dnnspaul/paulander/sketch/sketch.ino

#include <Wire.h>
#include <GxEPD2_BW.h>
#include <GxEPD2_3C.h>
#include <Fonts/FreeMonoBold9pt7b.h>
#include <Fonts/FreeMonoBold12pt7b.h>
#include <Fonts/FreeMono9pt7b.h>
#include <ArduinoJson.h>
#include <time.h>

// Pin definitions for 7.5" B&W e-paper display
#define EPD_CS 5
#define EPD_DC 2
#define EPD_RST 4
#define EPD_BUSY 15
#define EPD_PWR 0

// I2C configuration - using working parameters from your test
#define I2C_SDA 21
#define I2C_SCL 22
#define I2C_ADDRESS 0x42  // Changed to match Python code expectations

// Display object for Waveshare 7.5" V2 B&W display (800x480)
GxEPD2_BW<GxEPD2_750_T7, GxEPD2_750_T7::HEIGHT> display(GxEPD2_750_T7(EPD_CS, EPD_DC, EPD_RST, EPD_BUSY));

// Enhanced data structure for weather and calendar info
struct WeatherData {
  float current_temperature;
  char current_description[64];
  float today_min;
  float today_max;
  char today_description[64];
  float tomorrow_min;
  float tomorrow_max;
  char tomorrow_description[64];
  bool has_tomorrow_data;
  char location[32];
  int humidity;          // Humidity percentage
  float wind_speed;      // Wind speed
  uint32_t timestamp;
};

struct CalendarEvent {
  char title[64];
  char location[32];
  uint32_t start_time;
  bool valid;
  bool all_day;
};

struct DisplayData {
  WeatherData weather;
  CalendarEvent events[6];  // Max 6 events
  uint8_t event_count;
  uint32_t data_hash;  // Local hash to detect changes
  char received_hash[16];  // Hash received from Python backend
  uint32_t timestamp;
};

// Global variables
DisplayData currentData;
DisplayData previousData;
bool dataReceived = false;
bool displayNeedsUpdate = false;
bool displayInitialized = false;
unsigned long lastDisplayUpdate = 0;
const unsigned long DISPLAY_UPDATE_INTERVAL = 1800000;  // 30 minutes in ms
uint32_t skippedUpdates = 0;  // Counter for skipped updates due to hash matching

// I2C receive buffer - 2KB to handle complete data structure with headroom
uint8_t i2cBuffer[2048];  // 2KB buffer for reliable data reception
volatile bool i2cDataReady = false;
volatile int i2cDataLength = 0;
volatile int totalDataReceived = 0;
volatile bool receivingMultipart = false;
volatile unsigned long lastReceiveTime = 0;  // Global variable for timeout tracking

void setup() {
  Serial.begin(115200);
  Serial.println("\n=== Paulander ESP32 B&W Display Controller ===");

  // Configure timezone for Europe/Berlin (no WiFi needed, just local timezone setting)
  setenv("TZ", "CET-1CEST,M3.5.0,M10.5.0/3", 1);
  tzset();
  Serial.println("Timezone set to Europe/Berlin (CET/CEST)");

  // Debug: Print structure sizes
  Serial.printf("WeatherData size: %d bytes\n", sizeof(WeatherData));
  Serial.printf("CalendarEvent size: %d bytes\n", sizeof(CalendarEvent));
  Serial.printf("DisplayData size: %d bytes\n", sizeof(DisplayData));
  Serial.printf("Expected data from Pi: 719 bytes\n");

  // Initialize I2C first with explicit parameters (like your working test)
  Serial.println("Initializing I2C slave communication...");
  Wire.begin(I2C_ADDRESS, I2C_SDA, I2C_SCL, 100000);  // Address, SDA, SCL, Frequency
  Wire.onReceive(onI2CReceive);
  Wire.onRequest(onI2CRequest);

  Serial.printf("I2C initialized as slave at address 0x%02X\n", I2C_ADDRESS);
  Serial.printf("SDA: GPIO%d, SCL: GPIO%d\n", I2C_SDA, I2C_SCL);

  // Initialize display (but make it more robust)
  initializeDisplay();

  // Initialize data structures
  memset(&currentData, 0, sizeof(DisplayData));
  memset(&previousData, 0, sizeof(DisplayData));
  
  // Initialize hash fields
  strcpy(currentData.received_hash, "initial");
  strcpy(previousData.received_hash, "none");

  // Initialize I2C timing
  lastReceiveTime = millis();

  Serial.println("ESP32 ready for I2C communication");
  Serial.println("Waiting for data from Raspberry Pi...");

  // Show startup message only if display initialized
  if (displayInitialized) {
    showStartupMessage();
  }
}

void loop() {
  // Check for I2C data
  if (i2cDataReady) {
    processI2CData();
    i2cDataReady = false;
  }

  // Check for I2C receive timeout
  if (receivingMultipart && (millis() - lastReceiveTime > 15000)) {  // Increased to 15 seconds
    Serial.printf("I2C receive timeout - received %d bytes (expected JSON data)\n", totalDataReceived);

    // Check if we have complete JSON even though we timed out
    if (isJsonComplete()) {
      Serial.println("Data size close to expected - processing anyway");
      i2cDataLength = totalDataReceived;
      i2cDataReady = true;
    } else {
      Serial.println("Insufficient data - resetting buffer");
      // Clear the buffer completely to avoid contamination
      memset(i2cBuffer, 0, sizeof(i2cBuffer));
    }

    totalDataReceived = 0;
    receivingMultipart = false;
    lastReceiveTime = millis();
  }

  // Check if display needs update
  bool timeBasedUpdate = (millis() - lastDisplayUpdate > DISPLAY_UPDATE_INTERVAL);
  
  if (displayNeedsUpdate || timeBasedUpdate) {
    if (dataReceived && displayInitialized) {
      if (displayNeedsUpdate) {
        Serial.println("Display update triggered by data change");
      } else if (timeBasedUpdate) {
        Serial.println("Display update triggered by time interval (30 min)");
      }
      
      updateDisplay();
      displayNeedsUpdate = false;
      lastDisplayUpdate = millis();
    }
  }

  // Keep alive message every 10 seconds
  static unsigned long lastKeepAlive = 0;
  if (millis() - lastKeepAlive > 10000) {
    if (receivingMultipart) {
      Serial.printf("ESP32 running... (receiving multipart: %d bytes received)\n", totalDataReceived);
    } else {
      Serial.printf("ESP32 running... (data received: %s, skipped updates: %u)\n", dataReceived ? "yes" : "no", skippedUpdates);
    }
    lastKeepAlive = millis();
  }

  delay(100);  // Small delay to prevent busy waiting
}

void initializeDisplay() {
  Serial.println("Initializing 7.5\" B&W e-paper display...");

  try {
    delay(1000);  // Initialization pause

    // Power pin
    if (EPD_PWR >= 0) {
      pinMode(EPD_PWR, OUTPUT);
      digitalWrite(EPD_PWR, HIGH);
      delay(500);
      Serial.println("Power pin activated");
    }

    // Set pin modes explicitly
    pinMode(EPD_CS, OUTPUT);
    pinMode(EPD_DC, OUTPUT);
    pinMode(EPD_RST, OUTPUT);
    pinMode(EPD_BUSY, INPUT);

    digitalWrite(EPD_CS, HIGH);
    digitalWrite(EPD_DC, LOW);
    digitalWrite(EPD_RST, HIGH);

    display.init(115200, true, 2, false);

    // Set rotation for portrait mode (90 degrees clockwise)
    display.setRotation(3);

    Serial.println("✓ Display initialized successfully!");
    Serial.printf("Display size: %dx%d (after rotation)\n", display.width(), display.height());

    // Wait until display is ready
    Serial.println("Waiting for display readiness...");
    int timeout = 0;
    while (digitalRead(EPD_BUSY) == LOW && timeout < 50) {
      delay(100);
      timeout++;
      Serial.print(".");
    }
    Serial.println("\nDisplay is ready!");

    displayInitialized = true;

  } catch (...) {
    Serial.println("✗ Display initialization failed!");
    Serial.println("Continuing without display (I2C will still work)");
    displayInitialized = false;
  }
}

void onI2CReceive(int length) {
  if (length > 0) {
    // If this is the first chunk of a new transmission, clear buffer
    if (totalDataReceived == 0) {
      memset(i2cBuffer, 0, sizeof(i2cBuffer));
      Serial.println("Starting new I2C transmission - buffer cleared");
    }

    // Read all available bytes
    int bytesRead = 0;
    while (Wire.available() && (totalDataReceived + bytesRead) < sizeof(i2cBuffer)) {
      i2cBuffer[totalDataReceived + bytesRead] = Wire.read();
      bytesRead++;
    }

    totalDataReceived += bytesRead;
    Serial.printf("I2C chunk received: %d bytes (total: %d)\n", bytesRead, totalDataReceived);

    // Debug: Show first few bytes of this chunk if it's the first one
    if (totalDataReceived <= 32) {
      Serial.printf("First chunk bytes: ");
      for (int i = 0; i < min(8, bytesRead); i++) {
        uint8_t byte = i2cBuffer[totalDataReceived - bytesRead + i];
        if (byte >= 32 && byte <= 126) {
          Serial.printf("'%c' ", byte);  // Show printable characters
        } else {
          Serial.printf("0x%02X ", byte);  // Show non-printable as hex
        }
      }
      Serial.println();
    }

    // Check if we have received complete JSON data
    if (isJsonComplete()) {
      Serial.printf("Complete data received: %d bytes (expected: %d)\n", totalDataReceived, sizeof(DisplayData));
      i2cDataLength = totalDataReceived;
      i2cDataReady = true;
      totalDataReceived = 0;  // Reset for next message
      receivingMultipart = false;
    } else {
      // We're in the middle of receiving a multi-part message
      receivingMultipart = true;

      // Update global timeout timer
      lastReceiveTime = millis();

      // Check for timeout in main loop
    }
  }
}

bool isJsonComplete() {
  // Check if we have received complete JSON data
  if (totalDataReceived < 20) return false;  // Minimum for basic JSON structure

  bool foundStart = false;
  int braceCount = 0;

  for (int i = 0; i < totalDataReceived; i++) {
    if (i2cBuffer[i] == 0x00) continue;  // Skip register bytes

    if (i2cBuffer[i] == '{') {
      if (!foundStart) foundStart = true;
      braceCount++;
    } else if (i2cBuffer[i] == '}' && foundStart) {
      braceCount--;
      if (braceCount == 0) {
        Serial.printf("JSON completion detected at position %d (braces balanced)\n", i);
        return true;
      }
    }
  }

  return false;
}

void onI2CRequest() {
  // Send status back to Raspberry Pi
  uint8_t status = dataReceived ? 1 : 0;
  Wire.write(status);
  Serial.printf("I2C status request - sent: %d\n", status);
}

void processI2CData() {
  Serial.printf("Processing I2C data: %d bytes\n", i2cDataLength);

  if (i2cDataLength >= 50) {  // JSON should be at least 50 bytes
    // Reconstruct JSON by removing register bytes (0x00) from chunks
    // Each 16-byte chunk starts with 0x00, so we need to clean this up
    uint8_t cleanBuffer[2048];
    int cleanLength = 0;

    Serial.println("Reconstructing JSON from I2C chunks...");
    for (int i = 0; i < i2cDataLength;) {
      if (i2cBuffer[i] == 0x00) {
        // Skip register byte
        i++;
        Serial.printf("Skipped register byte at position %d\n", i - 1);
      } else {
        // Copy data byte
        cleanBuffer[cleanLength++] = i2cBuffer[i];
        i++;
      }
    }

    // Null-terminate the JSON string
    cleanBuffer[cleanLength] = '\0';

    Serial.printf("Reconstructed JSON: %d bytes (from %d raw bytes)\n", cleanLength, i2cDataLength);

    Serial.println("=== JSON Data Debug ===");
    Serial.printf("Clean JSON length: %d bytes\n", cleanLength);
    Serial.printf("Clean JSON data: %s\n", (char*)cleanBuffer);

    // Parse JSON from clean buffer
    DynamicJsonDocument doc(2048);  // 2KB for JSON parsing
    DeserializationError error = deserializeJson(doc, (char*)cleanBuffer);

    if (error) {
      Serial.printf("✗ JSON parsing failed: %s\n", error.c_str());
      return;
    }

    Serial.println("✓ JSON parsed successfully");

    // Extract enhanced weather data
    currentData.weather.current_temperature = doc["weather"]["current_temperature"];
    strncpy(currentData.weather.current_description, doc["weather"]["current_description"] | "", sizeof(currentData.weather.current_description) - 1);
    currentData.weather.today_min = doc["weather"]["today_min"];
    currentData.weather.today_max = doc["weather"]["today_max"];
    strncpy(currentData.weather.today_description, doc["weather"]["today_description"] | "", sizeof(currentData.weather.today_description) - 1);
    
    // Check if tomorrow data is available
    if (doc["weather"]["tomorrow_min"].isNull() || doc["weather"]["tomorrow_max"].isNull()) {
      currentData.weather.has_tomorrow_data = false;
      currentData.weather.tomorrow_min = 0;
      currentData.weather.tomorrow_max = 0;
      strncpy(currentData.weather.tomorrow_description, "No forecast", sizeof(currentData.weather.tomorrow_description) - 1);
    } else {
      currentData.weather.has_tomorrow_data = true;
      currentData.weather.tomorrow_min = doc["weather"]["tomorrow_min"];
      currentData.weather.tomorrow_max = doc["weather"]["tomorrow_max"];
      strncpy(currentData.weather.tomorrow_description, doc["weather"]["tomorrow_description"] | "No forecast", sizeof(currentData.weather.tomorrow_description) - 1);
    }
    
    strncpy(currentData.weather.location, doc["weather"]["location"] | "", sizeof(currentData.weather.location) - 1);
    
    // Extract new modern display fields (no icons)
    currentData.weather.humidity = doc["weather"]["humidity"] | 0;
    currentData.weather.wind_speed = doc["weather"]["wind_speed"] | 0.0;
    
    currentData.weather.timestamp = doc["weather"]["timestamp"];

    // Extract events data
    currentData.event_count = doc["event_count"];
    if (currentData.event_count > 6) currentData.event_count = 6;  // Safety check

    JsonArray events = doc["events"];
    for (int i = 0; i < currentData.event_count && i < 6; i++) {
      strncpy(currentData.events[i].title, events[i]["title"] | "", sizeof(currentData.events[i].title) - 1);
      strncpy(currentData.events[i].location, events[i]["location"] | "", sizeof(currentData.events[i].location) - 1);
      currentData.events[i].start_time = events[i]["start_time"];
      currentData.events[i].valid = events[i]["valid"];
      currentData.events[i].all_day = events[i]["all_day"] | false;
    }

    currentData.timestamp = doc["timestamp"];
    
    // Extract received hash from Python backend
    strncpy(currentData.received_hash, doc["data_hash"] | "", sizeof(currentData.received_hash) - 1);
    currentData.received_hash[sizeof(currentData.received_hash) - 1] = '\0';  // Ensure null termination

    // Calculate hash of current data for change detection
    uint32_t newHash = calculateDataHash(&currentData);

    Serial.println("=== JSON Data Processed Successfully ===");
    Serial.printf("Current Temperature: %.1f°C\n", currentData.weather.current_temperature);
    Serial.printf("Current Weather: %s\n", currentData.weather.current_description);
    Serial.printf("Humidity: %d%%, Wind: %.1fm/s\n", currentData.weather.humidity, currentData.weather.wind_speed);
    Serial.printf("Today: %.1f-%.1f°C, %s\n", currentData.weather.today_min, currentData.weather.today_max, currentData.weather.today_description);
    if (currentData.weather.has_tomorrow_data) {
      Serial.printf("Tomorrow: %.1f-%.1f°C, %s\n", currentData.weather.tomorrow_min, currentData.weather.tomorrow_max, currentData.weather.tomorrow_description);
    } else {
      Serial.println("Tomorrow: No forecast available");
    }
    Serial.printf("Location: %s\n", currentData.weather.location);
    Serial.printf("Events: %d\n", currentData.event_count);

    // Debug calendar events
    Serial.println("=== Calendar Events ===");
    for (int i = 0; i < currentData.event_count && i < 6; i++) {
      CalendarEvent& event = currentData.events[i];
      Serial.printf("Event %d: '%s'\n", i + 1, event.title);
      Serial.printf("  Location: '%s'\n", event.location);
      Serial.printf("  Start time: %u\n", event.start_time);
      Serial.printf("  Valid: %s\n", event.valid ? "yes" : "no");

      // Convert timestamp to readable format
      if (event.start_time > 0) {
        time_t eventTime = event.start_time;
        struct tm* timeInfo = localtime(&eventTime);
        Serial.printf("  Readable time: %02d/%02d %02d:%02d\n",
                      timeInfo->tm_mon + 1, timeInfo->tm_mday,
                      timeInfo->tm_hour, timeInfo->tm_min);
      }
    }

    Serial.printf("Local data hash: 0x%08X\n", newHash);
    Serial.printf("Received hash: %s\n", currentData.received_hash);

    // Enhanced change detection using both local hash and received hash
    bool localHashChanged = (newHash != previousData.data_hash);
    bool receivedHashChanged = (strcmp(currentData.received_hash, previousData.received_hash) != 0);
    
    if (localHashChanged || receivedHashChanged) {
      if (localHashChanged && receivedHashChanged) {
        Serial.println("✓ Data changed (both local and received hash) - display update needed");
      } else if (localHashChanged) {
        Serial.println("✓ Data changed (local hash) - display update needed");
      } else {
        Serial.println("✓ Data changed (received hash) - display update needed");
      }
      
      displayNeedsUpdate = true;
      previousData = currentData;
      previousData.data_hash = newHash;
      strncpy(previousData.received_hash, currentData.received_hash, sizeof(previousData.received_hash));
    } else {
      skippedUpdates++;
      Serial.printf("✓ Data unchanged (both hashes match) - no display update needed (skipped: %u)\n", skippedUpdates);
    }

    currentData.data_hash = newHash;
    dataReceived = true;
  } else {
    Serial.printf("✗ Insufficient I2C data: %d bytes (expected: 50+ bytes for JSON)\n", i2cDataLength);
  }
}

uint32_t calculateDataHash(DisplayData* data) {
  // Simple hash calculation for change detection
  uint32_t hash = 0;
  uint8_t* ptr = (uint8_t*)data;
  for (int i = 0; i < sizeof(DisplayData) - sizeof(uint32_t); i++) {
    hash = hash * 31 + ptr[i];
  }
  return hash;
}

void showStartupMessage() {
  if (!displayInitialized) return;

  display.fillScreen(GxEPD_WHITE);
  display.setTextColor(GxEPD_BLACK);
  display.setFont(&FreeMonoBold12pt7b);

  display.setCursor(50, 80);
  display.print("Paulander Display Controller");

  display.setFont(&FreeMono9pt7b);
  display.setCursor(50, 120);
  display.print("ESP32 Controller ready");

  display.setCursor(50, 150);
  display.print("I2C Address: 0x42 (0x2A)");

  display.setCursor(50, 180);
  display.print("Waiting for data from Raspberry Pi...");

  display.setCursor(50, 240);
  display.print("This shouldn't take longer");

  display.setCursor(50, 270);
  display.print("than 30 minutes!");

  // Draw border
  display.drawRect(20, 20, display.width() - 40, display.height() - 40, GxEPD_BLACK);

  Serial.println("Displaying startup message...");
  display.display();
  Serial.println("✓ Startup message displayed");
}

void updateDisplay() {
  if (!dataReceived || !displayInitialized) return;

  // Additional safety check - only update if we truly have new data
  if (!displayNeedsUpdate) {
    Serial.println("=== Display update skipped - no changes detected ===");
    return;
  }

  Serial.println("=== Updating Modern B&W Display ===");
  Serial.printf("Updating display due to data changes (hash: %s)\n", currentData.received_hash);

  display.fillScreen(GxEPD_WHITE);
  display.setTextColor(GxEPD_BLACK);

  // Modern card-based layout
  drawModernHeader();
  drawModernWeatherCards();
  drawModernEventsTimeline();
  drawModernFooter();

  Serial.println("Refreshing modern display (this may take 10-30 seconds)...");
  unsigned long startTime = millis();
  display.display();
  unsigned long endTime = millis();

  Serial.printf("✓ Modern display updated successfully in %lu ms\n", endTime - startTime);
}

void drawModernHeader() {
  // Two-line header: bold weekday on top, date (and optionally location) below.
  static const char* weekdays[] = {"Sonntag", "Montag", "Dienstag", "Mittwoch",
                                   "Donnerstag", "Freitag", "Samstag"};
  static const char* months[] = {"Januar", "Februar", "Maerz", "April", "Mai", "Juni",
                                 "Juli", "August", "September", "Oktober", "November", "Dezember"};

  time_t now = currentData.timestamp;
  struct tm timeInfo;
  localtime_r(&now, &timeInfo);

  int wday = timeInfo.tm_wday;
  if (wday < 0 || wday > 6) wday = 0;
  int mon = timeInfo.tm_mon;
  if (mon < 0 || mon > 11) mon = 0;

  // Line 1: weekday in Bold12pt (~14 px advance)
  display.setFont(&FreeMonoBold12pt7b);
  const char* weekdayStr = weekdays[wday];
  int wdayWidth = strlen(weekdayStr) * 14;
  display.setCursor((display.width() / 2) - (wdayWidth / 2), 24);
  display.print(weekdayStr);

  // Line 2: "30. April 2026" optionally followed by " - <Location>" in 9pt (~11 px advance).
  // Truncate the combined line if it would not fit within ~38 chars (440 px usable, 11 px/char).
  display.setFont(&FreeMono9pt7b);
  char dateLine[40];
  const char* loc = currentData.weather.location;
  if (strlen(loc) > 0) {
    snprintf(dateLine, sizeof(dateLine), "%d. %s %d - %s",
             timeInfo.tm_mday, months[mon], timeInfo.tm_year + 1900, loc);
  } else {
    snprintf(dateLine, sizeof(dateLine), "%d. %s %d",
             timeInfo.tm_mday, months[mon], timeInfo.tm_year + 1900);
  }
  int dateWidth = strlen(dateLine) * 11;
  display.setCursor((display.width() / 2) - (dateWidth / 2), 46);
  display.print(dateLine);

  // Header separator line
  display.drawLine(30, 56, display.width() - 30, 56, GxEPD_BLACK);
}

void drawModernWeatherCards() {
  // Consistent margins with other elements
  int marginLeft = 30;
  int marginRight = 30;
  int totalWidth = display.width() - marginLeft - marginRight;
  int cardWidth = (totalWidth - 40) / 3;  // 3 cards with 20px spacing between them
  int cardHeight = 130;
  int startY = 65;  // Below the new two-line header (separator at y=56)

  // JETZT — single instantaneous reading, so pass the same value for min/max.
  float now = currentData.weather.current_temperature;
  drawWeatherCard(marginLeft, startY, cardWidth, cardHeight, "JETZT",
                  now, now,
                  currentData.weather.current_description);

  // HEUTE — show min–max range
  drawWeatherCard(marginLeft + cardWidth + 20, startY, cardWidth, cardHeight, "HEUTE",
                  currentData.weather.today_min, currentData.weather.today_max,
                  currentData.weather.today_description);

  // MORGEN — show min–max range or fallback info card
  if (currentData.weather.has_tomorrow_data) {
    drawWeatherCard(marginLeft + (cardWidth * 2) + 40, startY, cardWidth, cardHeight, "MORGEN",
                    currentData.weather.tomorrow_min, currentData.weather.tomorrow_max,
                    currentData.weather.tomorrow_description);
  } else {
    drawInfoCard(marginLeft + (cardWidth * 2) + 40, startY, cardWidth, cardHeight, "MORGEN", "Keine Daten");
  }

  // Weather details bar below cards with consistent width
  drawWeatherDetailsBar(marginLeft, startY + cardHeight + 10);
}

void drawWeatherCard(int x, int y, int width, int height, const char* title,
                     float tempMin, float tempMax, const char* description) {
  // Single 1 px border
  display.drawRect(x, y, width, height, GxEPD_BLACK);

  // Title - properly centered (FreeMono9pt7b advance ~11 px)
  display.setFont(&FreeMono9pt7b);
  int titleWidth = strlen(title) * 11;
  display.setCursor(x + (width / 2) - (titleWidth / 2), y + 20);
  display.print(title);

  // Temperature - render single value or min–max range.
  // The default Adafruit GFX 12pt font table is ASCII-only, so the UTF-8 bytes for
  // "°" (0xC2 0xB0) are silently dropped. Compute centering from visible chars
  // (= strlen − 2 for the one ° sequence in the format string), at 14 px per glyph.
  display.setFont(&FreeMonoBold12pt7b);
  char tempStr[16];
  if ((int)roundf(tempMin) == (int)roundf(tempMax)) {
    snprintf(tempStr, sizeof(tempStr), "%.0f°C", tempMin);
  } else {
    snprintf(tempStr, sizeof(tempStr), "%.0f-%.0f°", tempMin, tempMax);
  }
  int visibleChars = (int)strlen(tempStr) - 2;
  if (visibleChars < 0) visibleChars = 0;
  display.setCursor(x + (width / 2) - ((visibleChars * 14) / 2), y + 60);
  display.print(tempStr);

  // Description - cap at 11 chars so 11 × 11 = 121 px fits the ~126 px card.
  display.setFont(&FreeMono9pt7b);
  String desc = String(description);
  if (desc.length() > 11) {
    desc = desc.substring(0, 9) + "..";
  }
  int descWidth = desc.length() * 11;
  display.setCursor(x + (width / 2) - (descWidth / 2), y + height - 20);
  display.print(desc);
}

void drawInfoCard(int x, int y, int width, int height, const char* title, const char* info) {
  // Simple info card
  display.drawRect(x, y, width, height, GxEPD_BLACK);
  
  // Title - properly centered (FreeMono9pt7b advance ~11 px)
  display.setFont(&FreeMono9pt7b);
  int titleWidth = strlen(title) * 11;
  int titleX = x + (width / 2) - (titleWidth / 2);
  display.setCursor(titleX, y + 20);
  display.print(title);

  // Info text (FreeMono9pt7b advance ~11 px)
  display.setFont(&FreeMono9pt7b);
  int infoX = x + (width / 2) - ((strlen(info) * 11) / 2);
  display.setCursor(infoX, y + height/2 + 5);
  display.print(info);
}

void drawWeatherDetailsBar(int x, int y) {
  // Weather details in a horizontal bar - consistent width with other elements
  int barWidth = display.width() - 60;  // Same margins as header and footer (30px each side)
  int barHeight = 25;
  
  display.drawRect(x, y, barWidth, barHeight, GxEPD_BLACK);
  
  display.setFont(&FreeMono9pt7b);
  
  // Humidity - German abbreviation
  if (currentData.weather.humidity > 0) {
    display.setCursor(x + 10, y + 18);
    display.printf("F:%d%%", currentData.weather.humidity);  // F for "Feuchtigkeit"
  }
  
  // Wind speed - German abbreviation
  if (currentData.weather.wind_speed > 0) {
    display.setCursor(x + 80, y + 18);
    display.printf("W:%.1fm/s", currentData.weather.wind_speed);  // W for "Wind" (same in German)
  }
  
  // Data age indicator instead of time - German text
  time_t now = currentData.timestamp;
  time_t updateTime = currentData.weather.timestamp;
  int ageMinutes = (now - updateTime) / 60;
  display.setCursor(x + barWidth - 100, y + 18);
  if (ageMinutes < 60) {
    display.printf("vor %dm", ageMinutes);  // German: "vor X Minuten"
  } else {
    display.printf("vor %dh", ageMinutes / 60);  // German: "vor X Stunden"
  }
}


void drawModernEventsTimeline() {
  // Consistent margins with other elements
  int marginLeft = 30;
  int timelineStartY = 270;  // More spacing from humidity bar (185+25+60=250)
  int timelineWidth = display.width() - 60;  // Same margins as other elements (30px each side)
  int eventCardWidth = timelineWidth;

  // Events section header - German
  display.setFont(&FreeMonoBold12pt7b);
  display.setCursor(marginLeft, timelineStartY);
  display.print("TERMINE");  // German for "EVENTS"

  int currentY = timelineStartY + 25;

  if (currentData.event_count == 0) {
    drawNoEventsCard(marginLeft, currentY, eventCardWidth);
    return;
  }

  int bottomLimit = display.height() - 60;
  int lastDay = -1, lastMonth = -1, lastYear = -1;
  int eventsDrawn = 0;

  for (int i = 0; i < currentData.event_count && i < 8; i++) {
    CalendarEvent& event = currentData.events[i];
    if (!event.valid || event.start_time == 0) continue;

    time_t eventTime = event.start_time;
    struct tm eventTm;
    localtime_r(&eventTime, &eventTm);

    bool needsDateHeader = (eventTm.tm_mday != lastDay ||
                            eventTm.tm_mon  != lastMonth ||
                            eventTm.tm_year != lastYear);

    int requiredHeight = (needsDateHeader ? 28 : 0) + 40;
    if (currentY + requiredHeight > bottomLimit) break;

    if (needsDateHeader) {
      drawEventDateHeader(marginLeft, currentY, eventCardWidth, &eventTm);
      currentY += 28;
      lastDay = eventTm.tm_mday;
      lastMonth = eventTm.tm_mon;
      lastYear = eventTm.tm_year;
    }

    drawEventTimelineCard(marginLeft, currentY, eventCardWidth, event);
    currentY += 50;
    eventsDrawn++;
  }

  // If more events than we drew, show remaining count - German text
  int remaining = currentData.event_count - eventsDrawn;
  if (remaining > 0 && currentY < bottomLimit) {
    display.setFont(&FreeMono9pt7b);
    display.setCursor(marginLeft, currentY);
    display.printf("+ %d weitere...", remaining);  // German: "+ X weitere..."
  }
}

void drawEventDateHeader(int x, int y, int width, struct tm* eventTm) {
  // German weekday abbreviations (tm_wday: 0=Sunday)
  const char* weekdays[] = {"So", "Mo", "Di", "Mi", "Do", "Fr", "Sa"};

  // Compare against today and tomorrow based on the data timestamp
  time_t now = currentData.timestamp;
  struct tm nowTm;
  localtime_r(&now, &nowTm);

  time_t tomorrow = now + 86400;
  struct tm tomorrowTm;
  localtime_r(&tomorrow, &tomorrowTm);

  bool isToday = (eventTm->tm_mday == nowTm.tm_mday &&
                  eventTm->tm_mon  == nowTm.tm_mon  &&
                  eventTm->tm_year == nowTm.tm_year);
  bool isTomorrow = (eventTm->tm_mday == tomorrowTm.tm_mday &&
                     eventTm->tm_mon  == tomorrowTm.tm_mon  &&
                     eventTm->tm_year == tomorrowTm.tm_year);

  char label[48];
  int wday = eventTm->tm_wday;
  if (wday < 0 || wday > 6) wday = 0;

  if (isToday) {
    snprintf(label, sizeof(label), "HEUTE - %s, %02d.%02d.",
             weekdays[wday], eventTm->tm_mday, eventTm->tm_mon + 1);
  } else if (isTomorrow) {
    snprintf(label, sizeof(label), "MORGEN - %s, %02d.%02d.",
             weekdays[wday], eventTm->tm_mday, eventTm->tm_mon + 1);
  } else if (eventTm->tm_year == nowTm.tm_year) {
    snprintf(label, sizeof(label), "%s, %02d.%02d.",
             weekdays[wday], eventTm->tm_mday, eventTm->tm_mon + 1);
  } else {
    snprintf(label, sizeof(label), "%s, %02d.%02d.%d",
             weekdays[wday], eventTm->tm_mday, eventTm->tm_mon + 1, eventTm->tm_year + 1900);
  }

  // Draw bold label, then a separator line just under it spanning the row
  display.setFont(&FreeMonoBold9pt7b);
  display.setCursor(x, y + 16);
  display.print(label);
  display.drawLine(x, y + 24, x + width, y + 24, GxEPD_BLACK);
}

void drawEventTimelineCard(int x, int y, int width, CalendarEvent& event) {
  int cardHeight = 40;

  // No outer rectangle — the black HH:MM chip on the left is the visual anchor,
  // and the 10 px gap between rows separates events vertically.

  // Time chip (left side) — date shown in the date header above each group.
  // For all-day events, render "GANZ" instead of HH:MM.
  if (event.start_time > 0) {
    int timeBoxWidth = 70;
    display.fillRect(x, y, timeBoxWidth, cardHeight, GxEPD_BLACK);
    display.setTextColor(GxEPD_WHITE);
    display.setFont(&FreeMonoBold9pt7b);

    if (event.all_day) {
      // "--:--" mirrors the HH:MM shape to mean "no specific time" (5 chars × 11 = 55 px)
      display.setCursor(x + 8, y + 26);
      display.print("--:--");
    } else {
      time_t eventTime = event.start_time;
      struct tm timeInfo;
      localtime_r(&eventTime, &timeInfo);
      // Time centered in the 70 px chip (HH:MM is 5 monospace chars ~55 px wide)
      display.setCursor(x + 8, y + 26);
      display.printf("%02d:%02d", timeInfo.tm_hour, timeInfo.tm_min);
    }

    display.setTextColor(GxEPD_BLACK);  // Reset to black
  }
  
  // Event title and location (right side, after 70 px time box + 8 px gap)
  display.setFont(&FreeMonoBold9pt7b);

  // Title row is ~330 px usable (340 px from x+80 to card right border, less ~10 px margin).
  // FreeMonoBold9pt7b advances 11 px per char → 30 chars fit.
  String eventTitle = String(event.title);
  if (eventTitle.length() > 30) {
    eventTitle = eventTitle.substring(0, 28) + "..";
  }

  bool hasLocation = strlen(event.location) > 0;

  // Without a location the title is the only line — center it vertically in the 40 px card.
  // With a location, keep the two-line layout (title y+18, location y+32).
  display.setCursor(x + 80, hasLocation ? y + 18 : y + 25);
  display.print(eventTitle);

  if (hasLocation) {
    display.setFont(&FreeMono9pt7b);
    // "@ " prefix occupies 2 of the 30-char row budget, leaving 28 chars for the location.
    String location = String(event.location);
    if (location.length() > 28) {
      location = location.substring(0, 26) + "..";
    }
    display.setCursor(x + 80, y + 32);
    display.printf("@ %s", location.c_str());
  }
}

void drawNoEventsCard(int x, int y, int width) {
  int cardHeight = 40;

  display.drawRect(x, y, width, cardHeight, GxEPD_BLACK);

  display.setFont(&FreeMono9pt7b);
  const char* msg = "Keine Termine heute";  // German: "No events today"
  int msgWidth = strlen(msg) * 11;  // FreeMono9pt7b advance
  display.setCursor(x + (width / 2) - (msgWidth / 2), y + 25);
  display.print(msg);
}

void drawModernFooter() {
  if (!displayInitialized) return;
  
  int footerY = display.height() - 25;  // Move text up slightly
  
  // Modern status bar with consistent width
  display.drawLine(30, footerY - 20, display.width()-30, footerY - 20, GxEPD_BLACK);
  
  display.setFont(&FreeMono9pt7b);
  
  // Connection status
  display.setCursor(30, footerY);
  display.print("PAULANDER");
  
  // Last update time (weather timestamp - this is OK since it's not current time) - CENTERED - German
  time_t updateTime = currentData.weather.timestamp;
  struct tm* timeInfo = localtime(&updateTime);
  char updateText[25];
  sprintf(updateText, "Update:%02d:%02d", timeInfo->tm_hour, timeInfo->tm_min);  // Shorter German version
  int updateWidth = strlen(updateText) * 11;  // FreeMono9pt7b monospace advance
  int centerX = (display.width() / 2) - (updateWidth / 2);
  display.setCursor(centerX, footerY);
  display.print(updateText);
  
  // System status
  display.setCursor(display.width()-50, footerY);  // Adjusted for 30px margin
  display.print("<3");
}
