dnnspaul/paulander/src/services/display_service.py

import os
import sys
from PIL import Image
import numpy as np
from datetime import datetime
from typing import Dict, Any, List, Optional
from io import BytesIO
import json
from google import genai
from google.genai import types
import struct
import time
import random
import re
import pytz
import hashlib
import httpx
from src.services.config_service import ConfigService
from src.services.weather_service import WeatherService
from src.services.calendar_service import CalendarService
from src.services.weather_translations import translate_weather_description, translate_ui_text

# Add the waveshare library path from git submodule
waveshare_lib_path = os.path.join(os.path.dirname(__file__), '../../waveshare-epaper/RaspberryPi_JetsonNano/python/lib')
sys.path.append(waveshare_lib_path)

# Check if we should force mock mode (useful for development)
FORCE_MOCK_DISPLAY = os.getenv('FORCE_MOCK_DISPLAY', 'false').lower() == 'true'

# I2C configuration
ESP32_I2C_ADDRESS = 0x42
I2C_BUS = 1  # RPi I2C bus number

# Try to import I2C libraries
try:
    import smbus2
    I2C_AVAILABLE = True
except ImportError:
    I2C_AVAILABLE = False

# Global variables for lazy loading
epd7in3e = None
_epd7in3e_loaded = False
_epd7in3e_error = None

def _load_epd7in3e():
    """Lazy load the epd7in3e module to avoid GPIO conflicts at import time"""
    global epd7in3e, _epd7in3e_loaded, _epd7in3e_error
    
    if _epd7in3e_loaded:
        return epd7in3e
    
    if FORCE_MOCK_DISPLAY:
        print("FORCE_MOCK_DISPLAY is enabled - display functions will be mocked")
        epd7in3e = None
    else:
        try:
            # Import our custom RPi.GPIO-based epdconfig first
            from src.services import epdconfig_rpi_gpio
            
            # Import the waveshare module
            from waveshare_epd import epd7in3e as _epd7in3e
            
            # Monkey patch the epdconfig to use our RPi.GPIO implementation
            _epd7in3e.epdconfig = epdconfig_rpi_gpio
            
            epd7in3e = _epd7in3e
            print("Successfully imported epd7in3e module with RPi.GPIO patch")
            print(f"Patched epdconfig module: {epd7in3e.epdconfig.__name__}")
        except ImportError as e:
            print(f"Warning: Waveshare e-paper library not available: {e}")
            print("Display functions will be mocked.")
            epd7in3e = None
            _epd7in3e_error = e
        except Exception as e:
            print(f"Warning: Error importing display module: {e}")
            print("Display functions will be mocked.")
            epd7in3e = None
            _epd7in3e_error = e
    
    _epd7in3e_loaded = True
    return epd7in3e

class DisplayService:
    def __init__(self):
        self.config_service = ConfigService()
        self.weather_service = WeatherService()
        self.calendar_service = CalendarService()
        
        # Display dimensions
        self.COLOR_WIDTH = 800
        self.COLOR_HEIGHT = 480
        self.BW_WIDTH = 800  # These will be sent to ESP32 via I2C
        self.BW_HEIGHT = 480
        
        # Initialize color display (lazy loaded)
        self.color_epd = None
        self.display_initialized = False
        
        # I2C communication
        self.i2c_bus = None
        self.i2c_initialized = False
        
        # Data caching for B&W display
        self.cached_weather_data = None
        self.cached_calendar_data = None
        self.last_api_fetch = 0
        self.last_i2c_send = 0
        self.API_CACHE_DURATION = 1800  # 30 minutes in seconds
        self.I2C_SEND_INTERVAL = 30     # 30 seconds
        
        # Don't load the display module during init - wait until actually needed
        print("Display service initialized (hardware will be loaded on first use)")
    
    def _ensure_display_loaded(self):
        """Ensure the display hardware is loaded and initialized"""
        if self.color_epd is not None:
            return  # Already loaded
        
        # Lazy load the waveshare module
        epd_module = _load_epd7in3e()
        
        if epd_module:
            try:
                print("Lazy loading display hardware...")
                self.color_epd = epd_module.EPD()
                print("✓ Color display hardware loaded successfully")
            except Exception as e:
                print(f"✗ Warning: Could not initialize color display: {e}")
                print("This may be due to GPIO conflicts or hardware issues")
                self.color_epd = None
        else:
            print("✗ Waveshare module not available, display functions will be mocked")
            self.color_epd = None
    
    def _ensure_i2c_initialized(self):
        """Ensure I2C bus is initialized for ESP32 communication"""
        if self.i2c_initialized:
            return True
        
        if not I2C_AVAILABLE:
            print("✗ smbus2 not available, I2C communication will be mocked")
            return False
        
        if FORCE_MOCK_DISPLAY:
            print("✗ FORCE_MOCK_DISPLAY enabled, I2C communication will be mocked")
            return False
        
        try:
            self.i2c_bus = smbus2.SMBus(I2C_BUS)
            self.i2c_initialized = True
            print(f"✓ I2C bus {I2C_BUS} initialized for ESP32 communication")
            return True
        except Exception as e:
            print(f"✗ Failed to initialize I2C: {e}")
            return False

    def get_status(self) -> Dict[str, str]:
        """Get display status"""
        # Try to lazy load display if not already loaded
        if not self.color_epd:
            self._ensure_display_loaded()
        
        color_status = "active" if self.color_epd else "unavailable"
        bw_status = "active"  # Assume ESP32 connection is always available
        
        return {
            'color': color_status,
            'bw': bw_status,
            'last_color_refresh': self._get_last_refresh_time('color'),
            'last_bw_refresh': self._get_last_refresh_time('bw')
        }
    
    def get_output_image_path(self, display_type: str) -> Optional[str]:
        """Return the absolute path to the latest rendered color image.

        'color' -> the dithered AI image sent to the color panel.
        Returns None for any other type, or if no image has been rendered yet.
        (The B&W panel is rendered by the ESP32, so there is no Pi-side image.)
        """
        if display_type != 'color':
            return None
        path = os.path.abspath('debug_generated_image.png')
        return path if os.path.exists(path) else None

    def _get_last_refresh_time(self, display_type: str) -> str:
        """Get last refresh time from file"""
        filename = f"last_refresh_{display_type}.txt"
        try:
            if os.path.exists(filename):
                with open(filename, 'r') as f:
                    return f.read().strip()
        except:
            pass
        return "Never"
    
    def _set_last_refresh_time(self, display_type: str):
        """Set last refresh time to file"""
        filename = f"last_refresh_{display_type}.txt"
        try:
            with open(filename, 'w') as f:
                f.write(datetime.now().isoformat())
        except:
            pass
    
    def refresh_display(self, display_type: str = 'both') -> Dict[str, Any]:
        """Refresh display(s)"""
        result = {'success': True, 'messages': []}
        
        if display_type in ['color', 'both']:
            try:
                self.update_color_display()
                result['messages'].append('Color display refreshed successfully')
            except Exception as e:
                result['success'] = False
                result['messages'].append(f'Color display refresh failed: {str(e)}')
        
        if display_type in ['bw', 'both']:
            try:
                self.update_bw_display()
                result['messages'].append('B&W display refreshed successfully')
            except Exception as e:
                result['success'] = False
                result['messages'].append(f'B&W display refresh failed: {str(e)}')
        
        return result
    
    def update_color_display(self):
        """Update the color e-ink display with AI-generated image"""
        try:
            print("=== Starting color display update ===")
            
            # Generate AI image based on today's events and weather
            print("Generating AI image...")
            image = self.generate_daily_image()
            print(f"✓ Image generated: {image.size[0]}x{image.size[1]} pixels, mode: {image.mode}")
            
            # Rotate image by 180 degrees for display orientation
            print("Rotating image 180 degrees...")
            image = image.rotate(180)
            print(f"✓ Image rotated: {image.size[0]}x{image.size[1]} pixels, mode: {image.mode}")
            
            # Ensure display is loaded before using it
            if not self.color_epd:
                self._ensure_display_loaded()
            
            if self.color_epd:
                print("Hardware display detected, initializing...")
                
                # Get the epd module for cleanup operations
                epd_module = _load_epd7in3e()
                
                try:
                    # Initialize display with proper error handling and retry logic
                    if not self.display_initialized:
                        print("First time initialization, cleaning up any previous state...")
                        try:
                            if epd_module:
                                epd_module.epdconfig.module_exit(cleanup=True)
                        except Exception as cleanup_error:
                            print(f"Warning during cleanup: {cleanup_error}")
                        
                    print("Initializing display hardware...")
                    print(f"Using epdconfig: {epd_module.epdconfig.__name__}")
                    
                    # Try display initialization with retry logic
                    max_init_retries = 3
                    init_success = False
                    
                    for attempt in range(max_init_retries):
                        try:
                            print(f"Display initialization attempt {attempt + 1}/{max_init_retries}")
                            self.color_epd.init()
                            init_success = True
                            self.display_initialized = True
                            print("✓ Display initialized successfully")
                            break
                        except Exception as init_error:
                            print(f"✗ Initialization attempt {attempt + 1} failed: {init_error}")
                            if attempt < max_init_retries - 1:
                                print("Waiting 2 seconds before retry...")
                                time.sleep(2)
                                # Force cleanup between retries
                                try:
                                    if epd_module:
                                        epd_module.epdconfig.module_exit(cleanup=True)
                                        # Reinitialize the display object
                                        self.color_epd = epd_module.EPD()
                                        self.display_initialized = False
                                except:
                                    pass
                            else:
                                raise init_error
                    
                    if not init_success:
                        raise Exception("Failed to initialize display after all retry attempts")
                    
                    print("Clearing display...")
                    self.color_epd.Clear()
                    print("✓ Display cleared")
                    
                    # Display the image
                    print("Converting image to display buffer...")
                    buffer = self.color_epd.getbuffer(image)
                    print(f"✓ Buffer created, size: {len(buffer) if buffer else 'None'} bytes")
                    
                    print("Sending image to display...")
                    self.color_epd.display(buffer)
                    print("✓ Image sent to display")
                    
                    # Put display to sleep to save power
                    print("Putting display to sleep...")
                    self.color_epd.sleep()
                    print("✓ Display in sleep mode")
                    
                    print("✓ Color display updated successfully")
                    
                except Exception as gpio_error:
                    print(f"✗ GPIO/Display error: {gpio_error}")
                    
                    # Try to recover by reinitializing the entire display
                    print("Attempting display recovery...")
                    try:
                        # Clean up completely
                        if epd_module:
                            epd_module.epdconfig.module_exit(cleanup=True)
                        
                        # Reinitialize the display object
                        self.color_epd = epd_module.EPD() if epd_module else None
                        self.display_initialized = False
                        
                        if self.color_epd:
                            # Try initialization again
                            self.color_epd.init()
                            self.display_initialized = True
                            print("✓ Display recovery successful")
                            
                            # Now try the display operation again
                            self.color_epd.Clear()
                            buffer = self.color_epd.getbuffer(image)
                            self.color_epd.display(buffer)
                            self.color_epd.sleep()
                            print("✓ Color display updated successfully after recovery")
                        else:
                            raise Exception("Could not reinitialize display")
                        
                    except Exception as recovery_error:
                        print(f"✗ Display recovery failed: {recovery_error}")
                        # Save image as fallback
                        filename = 'color_display_output_gpio_error.png'
                        image.save(filename)
                        print(f"✓ Image saved as {filename} due to GPIO error")
                        raise Exception(f"Display hardware error: {gpio_error}")
            else:
                # Save image for testing
                filename = 'color_display_output.png'
                image.save(filename)
                print(f"✓ Color display mocked - image saved as {filename}")
                print(f"  Image details: {image.size[0]}x{image.size[1]} pixels, {image.mode} mode")
            
            self._set_last_refresh_time('color')
            print("✓ Last refresh time updated")
            print("=== Color display update completed ===")
            
        except Exception as e:
            print(f"✗ Color display update failed: {str(e)}")
            import traceback
            print(f"Traceback: {traceback.format_exc()}")
            raise Exception(f"Color display update failed: {str(e)}")
    
    def update_bw_display(self):
        """Update the B&W display via ESP32 with weather and calendar info"""
        try:
            print("=== Starting B&W display update ===")
            
            # Check if we need to fetch fresh data from APIs (every 30 minutes)
            current_time = time.time()
            if (current_time - self.last_api_fetch) >= self.API_CACHE_DURATION:
                print("Fetching fresh data from APIs...")
                self._fetch_and_cache_data()
                self.last_api_fetch = current_time
            else:
                print("Using cached data (API cache still valid)")
            
            # Send data to ESP32 via I2C (every 30 seconds)
            if (current_time - self.last_i2c_send) >= self.I2C_SEND_INTERVAL:
                print("Sending data to ESP32 via I2C...")
                self._send_data_to_esp32()
                self.last_i2c_send = current_time
            else:
                print("I2C send interval not reached yet")
            
            self._set_last_refresh_time('bw')
            print("✓ B&W display update completed")
            
        except Exception as e:
            print(f"✗ B&W display update failed: {e}")
            raise Exception(f"B&W display update failed: {str(e)}")
    
    def _fetch_and_cache_data(self):
        """Fetch fresh weather and calendar data from APIs and cache it"""
        try:
            # Fetch enhanced weather data (current temp, today min/max, tomorrow forecast)
            print("Fetching enhanced weather data...")
            weather = self.weather_service.get_enhanced_weather_for_display()
            
            # Also fetch current weather for additional data (humidity, wind, icon)
            print("Fetching current weather details for modern display...")
            current_weather = self.weather_service.get_current_weather()
            
            # Translate weather descriptions to German before caching
            current_desc = weather.get('current_description', 'N/A')
            today_desc = weather.get('today_description', 'N/A')
            tomorrow_desc = weather.get('tomorrow_description', 'N/A') if weather.get('tomorrow_description') else None
            
            self.cached_weather_data = {
                'current_temperature': weather.get('current_temperature', 0.0),
                'current_description': translate_weather_description(current_desc)[:63],  # Translate and limit to 63 chars
                'today_min': weather.get('today_min', 0.0),
                'today_max': weather.get('today_max', 0.0),
                'today_description': translate_weather_description(today_desc)[:63],  # Translate and limit
                'tomorrow_min': weather.get('tomorrow_min'),
                'tomorrow_max': weather.get('tomorrow_max'),
                'tomorrow_description': translate_weather_description(tomorrow_desc)[:63] if tomorrow_desc else None,  # Translate if available
                'location': weather.get('location', '')[:31],  # Limit to 31 chars
                # Enhanced data for modern display (no icons)
                'humidity': int(current_weather.get('humidity', 0)),
                'wind_speed': float(current_weather.get('wind_speed', 0.0)),
                'timestamp': int(time.time())
            }
            print(f"✓ Enhanced weather cached:")
            print(f"  Current: {self.cached_weather_data['current_temperature']}°C, {self.cached_weather_data['current_description']}")
            print(f"  Today: {self.cached_weather_data['today_min']}-{self.cached_weather_data['today_max']}°C, {self.cached_weather_data['today_description']}")
            if self.cached_weather_data['tomorrow_min'] is not None:
                print(f"  Tomorrow: {self.cached_weather_data['tomorrow_min']}-{self.cached_weather_data['tomorrow_max']}°C, {self.cached_weather_data['tomorrow_description']}")
            print(f"  Modern data: Humidity={self.cached_weather_data.get('humidity', 0)}%, Wind={self.cached_weather_data.get('wind_speed', 0)}m/s")
            
            # Fetch calendar data
            print("Fetching calendar events...")
            events = self.calendar_service.get_upcoming_events(days_ahead=3)
            
            self.cached_calendar_data = []
            
            if events:
                for i, event in enumerate(events[:6]):  # Limit to 6 events
                    # Safely handle start time (keep as UTC timestamp - ESP32 will convert to local timezone)
                    start_time = 0
                    event_start = event.get('start') if event else None
                    
                    if event_start is not None and hasattr(event_start, 'timestamp'):
                        try:
                            start_time = int(event_start.timestamp())
                        except (AttributeError, TypeError):
                            start_time = 0
                    
                    # Safely handle other fields
                    title = event.get('title', '') if event else ''
                    location = event.get('location', '') if event else ''
                    
                    event_data = {
                        'title': self._sanitize_text_for_display(title)[:63],  # Limit to 63 chars
                        'location': self._sanitize_text_for_display(location)[:31] if location else '',  # Limit to 31 chars
                        'start_time': start_time,
                        'valid': bool(title),
                        'all_day': bool(event.get('all_day', False)),
                    }
                    self.cached_calendar_data.append(event_data)
            
            print(f"✓ Calendar cached: {len(self.cached_calendar_data)} events")
            
        except Exception as e:
            print(f"✗ Error fetching API data: {e}")
            import traceback
            print(f"Full traceback: {traceback.format_exc()}")
            
            # Use fallback data if APIs fail - with German translations
            if not self.cached_weather_data:
                self.cached_weather_data = {
                    'current_temperature': 0.0,
                    'current_description': translate_weather_description('Weather unavailable'),
                    'today_min': 0.0,
                    'today_max': 0.0,
                    'today_description': translate_weather_description('Data unavailable'),
                    'tomorrow_min': None,
                    'tomorrow_max': None,
                    'tomorrow_description': translate_weather_description('No forecast available'),
                    'location': '',
                    'humidity': 0,
                    'wind_speed': 0.0,
                    'timestamp': int(time.time())
                }
            if not self.cached_calendar_data:
                self.cached_calendar_data = []
    
    def _send_data_to_esp32(self):
        """Send cached weather and calendar data to ESP32 via I2C"""
        if not self.cached_weather_data:
            print("✗ No cached weather data to send")
            return
        
        # Initialize I2C if needed
        if not self._ensure_i2c_initialized():
            print("✗ I2C not available — cannot reach ESP32 (it renders the B&W panel)")
            return
        
        try:
            # Prepare data structure matching ESP32 expectations
            data = self._prepare_esp32_data()
            
            # Send data via I2C using simple write method (better for large data)
            print(f"Sending {len(data)} bytes to ESP32 at address 0x{ESP32_I2C_ADDRESS:02X}")
            
            # Wait a moment to ensure ESP32 is ready for new transmission
            time.sleep(0.1)
            
            # Send data in smaller chunks for better reliability
            # Use 15 bytes per chunk to ensure reliable transmission
            chunk_size = 15
            total_chunks = (len(data) + chunk_size - 1) // chunk_size
            print(f"Sending {total_chunks} chunks of max {chunk_size} bytes each...")
            
            chunks_sent = 0
            total_bytes_sent = 0
            
            for i in range(0, len(data), chunk_size):
                chunk = data[i:i+chunk_size]
                chunk_num = i // chunk_size + 1
                actual_chunk_size = len(chunk)
                
                # Retry mechanism for each chunk
                max_chunk_retries = 3
                chunk_sent = False
                
                for retry in range(max_chunk_retries):
                    try:
                        # Send JSON data directly without register byte prefix
                        # Use write_i2c_block_data with register 0x00 to avoid 0xFF corruption
                        chunk_list = list(chunk)
                        self.i2c_bus.write_i2c_block_data(ESP32_I2C_ADDRESS, 0x00, chunk_list)
                        chunk_sent = True
                        chunks_sent += 1
                        total_bytes_sent += actual_chunk_size
                        
                        if chunks_sent % 5 == 0:  # Progress every 5 chunks
                            print(f"Progress: {chunks_sent}/{total_chunks} chunks sent ({total_bytes_sent} bytes)")
                        
                        break  # Success, exit retry loop
                        
                    except Exception as chunk_error:
                        if retry < max_chunk_retries - 1:
                            print(f"Chunk {chunk_num} failed (attempt {retry + 1}), retrying...")
                            time.sleep(0.05)  # Wait before retry
                        else:
                            print(f"✗ Chunk {chunk_num} ({actual_chunk_size} bytes) failed after {max_chunk_retries} attempts: {chunk_error}")
                
                if not chunk_sent:
                    print("✗ Stopping transmission due to chunk failure")
                    break
                
                # Longer delay between chunks for ESP32 processing  
                time.sleep(0.05)  # 50ms delay between chunks for more reliable transmission
            
            print(f"✓ Transmission completed: {chunks_sent}/{total_chunks} chunks sent ({total_bytes_sent} total bytes)")
            
            # If transmission was incomplete, wait and check ESP32 status
            if chunks_sent < total_chunks:
                print(f"⚠ Incomplete transmission! Only {chunks_sent}/{total_chunks} chunks sent")
            
            # Give ESP32 time to process all chunks before status check
            time.sleep(0.1)
            
            # Read ESP32 status
            try:
                status = self.i2c_bus.read_byte(ESP32_I2C_ADDRESS)
                print(f"✓ ESP32 status: {'Data received' if status == 1 else 'Waiting for data'}")
                
                # If ESP32 still waiting and we sent all chunks, there might be a timing issue
                if status == 0 and chunks_sent == total_chunks:
                    print("⚠ ESP32 status shows 'waiting' despite complete transmission")
                
            except Exception as status_error:
                print(f"✓ Data sent (status read failed: {status_error})")
            
        except Exception as e:
            print(f"✗ I2C communication failed: {e}")
    
    def _prepare_esp32_data(self):
        """Prepare JSON data for ESP32 communication"""
        print(f"Preparing modern enhanced JSON data for ESP32")
        print(f"Weather - Current: {self.cached_weather_data['current_temperature']}°C, Today: {self.cached_weather_data['today_min']}-{self.cached_weather_data['today_max']}°C")
        print(f"Modern data - Humidity: {self.cached_weather_data.get('humidity', 0)}%, Wind: {self.cached_weather_data.get('wind_speed', 0)}m/s")
        
        # Prepare events data - only send the events we have
        events_data = []
        for i, event in enumerate(self.cached_calendar_data[:6]):  # Limit to 6 events
            event_data = {
                "title": self._sanitize_text_for_display(event['title'])[:63],  # Limit title length
                "location": self._sanitize_text_for_display(event['location']) if event['location'] != 'None' else '',
                "start_time": event['start_time'],
                "valid": event['valid'],
                "all_day": bool(event.get('all_day', False)),
            }
            events_data.append(event_data)
        
        # Create complete data structure with enhanced weather
        json_data = {
            "weather": {
                "current_temperature": float(self.cached_weather_data['current_temperature']),
                "current_description": self._sanitize_text_for_display(self.cached_weather_data['current_description'])[:63],
                "today_min": float(self.cached_weather_data['today_min']),
                "today_max": float(self.cached_weather_data['today_max']),
                "today_description": self._sanitize_text_for_display(self.cached_weather_data['today_description'])[:63],
                "tomorrow_min": float(self.cached_weather_data['tomorrow_min']) if self.cached_weather_data['tomorrow_min'] is not None else None,
                "tomorrow_max": float(self.cached_weather_data['tomorrow_max']) if self.cached_weather_data['tomorrow_max'] is not None else None,
                "tomorrow_description": self._sanitize_text_for_display(self.cached_weather_data['tomorrow_description'])[:63] if self.cached_weather_data['tomorrow_description'] else None,
                "location": self._sanitize_text_for_display(self.cached_weather_data['location'])[:31],
                # Enhanced modern display data (no icons)
                "humidity": int(self.cached_weather_data.get('humidity', 0)),
                "wind_speed": float(self.cached_weather_data.get('wind_speed', 0.0)),
                "timestamp": self.cached_weather_data['timestamp']
            },
            "events": events_data,
            "event_count": len(events_data),
            "timestamp": int(time.time())  # Current timestamp for data freshness
        }
        
        # Calculate hash for change detection
        data_hash = self._calculate_data_hash(json_data)
        json_data["data_hash"] = data_hash
        
        # Convert to JSON string and encode to bytes
        json_string = json.dumps(json_data, separators=(',', ':'))  # Compact JSON
        json_bytes = json_string.encode('utf-8')
        
        print(f"JSON data prepared: {len(json_bytes)} bytes")
        print(f"Event count: {len(events_data)}")
        print(f"Data hash: {data_hash}")
        print(f"JSON preview (first 100 chars): {json_string[:100]}...")
        
        return json_bytes
    
    def _sanitize_text_for_display(self, text: str) -> str:
        """Sanitize text by replacing German umlauts and special characters for ESP32 display"""
        if not text:
            return text
        
        # Replace German umlauts and special characters
        replacements = {
            'ä': 'ae',
            'ö': 'oe', 
            'ü': 'ue',
            'Ä': 'Ae',
            'Ö': 'Oe',
            'Ü': 'Ue',
            'ß': 'ss',
            'é': 'e',
            'è': 'e',
            'ê': 'e',
            'á': 'a',
            'à': 'a',
            'â': 'a',
            'í': 'i',
            'ì': 'i',
            'î': 'i',
            'ó': 'o',
            'ò': 'o',
            'ô': 'o',
            'ú': 'u',
            'ù': 'u',
            'û': 'u',
            'ç': 'c',
            'ñ': 'n'
        }
        
        sanitized = text
        for char, replacement in replacements.items():
            sanitized = sanitized.replace(char, replacement)
        
        # Remove any remaining non-ASCII characters
        sanitized = ''.join(char if ord(char) < 128 else '?' for char in sanitized)
        
        return sanitized
    
    def _calculate_data_hash(self, json_data: dict) -> str:
        """Calculate a hash of the JSON data for change detection"""
        # Create a consistent string representation for hashing
        # Sort keys to ensure consistent ordering
        json_string = json.dumps(json_data, sort_keys=True, separators=(',', ':'))
        # Calculate SHA256 hash and return first 8 characters (32-bit equivalent)
        hash_object = hashlib.sha256(json_string.encode('utf-8'))
        return hash_object.hexdigest()[:8]
    
    def generate_daily_image(self) -> Image.Image:
        """Generate AI image based on calendar events and weather"""
        print("=== Starting daily image generation ===")
        
        # Get today's data
        print("Fetching weather data...")
        weather_summary = self.weather_service.get_weather_summary_for_ai()
        print(f"✓ Weather summary: {weather_summary}")
        
        print("Fetching calendar events...")
        events = self.calendar_service.get_today_events()
        print(f"✓ Found {len(events)} events for today")
        
        # Generate image with Gemini
        gemini_api_key = self.config_service.get('gemini_api_key')
        
        if not gemini_api_key:
            raise ValueError("Gemini API key is required for image generation")
            
        print("✓ Gemini API key found, attempting AI image generation...")
        result = self._generate_gemini_image(weather_summary, events)
        print("✓ AI image generation completed successfully")
        return result
    
    def _generate_gemini_image(self, weather_summary: str, events: List[Dict]) -> Image.Image:
        """Generate image using Gemini API with two-step process"""
        gemini_api_key = self.config_service.get('gemini_api_key')
        print(f"Starting Gemini image generation process...")
        print(f"Weather summary: {weather_summary}")
        print(f"Events count: {len(events)}")
        
        # Step 1: Generate detailed prompt using Gemini 3.5 Flash
        prompt_generation_text = self._create_prompt_generation_request(weather_summary, events)
        print(f"Step 1: Generating detailed prompt with Gemini 3.5 Flash...")
        
        try:
            # Configure the new Gemini client
            client = genai.Client(
                api_key=gemini_api_key,
                http_options=types.HttpOptions(timeout=300_000)
            )

            print(f"Gemini client configured successfully")
            
            # Generate the detailed prompt with retry logic
            print(f"Calling Gemini 3.5 Flash for prompt generation...")
            prompt_response = self._retry_gemini_api_call(
                client.models.generate_content,
                model="gemini-3.5-flash",
                contents=[prompt_generation_text],
                config=types.GenerateContentConfig(
                    thinking_config=types.ThinkingConfig(thinking_level="high")
                )
            )
            
            detailed_prompt = prompt_response.text.strip()
            print(f"✓ Step 1 completed - Generated prompt: {detailed_prompt}")
            
            # Step 2: Generate image using the detailed prompt with retry logic
            print(f"Step 2: Generating image with Gemini 3.1 Flash Image (Nano Banana 2)...")
            print(f"Using prompt: {detailed_prompt[:100]}...")
            
            image_response = self._retry_gemini_api_call(
                client.models.generate_content,
                model="gemini-3.1-flash-image",
                contents=[detailed_prompt],
                config=types.GenerateContentConfig(
                    image_config=types.ImageConfig(image_size="1K")
                )
            )
            
            print(f"✓ Gemini API call completed, processing response...")
            print(f"Response object type: {type(image_response)}")
            print(f"Response candidates count: {len(image_response.candidates) if hasattr(image_response, 'candidates') else 'No candidates'}")
            
            if hasattr(image_response, 'candidates') and image_response.candidates:
                candidate = image_response.candidates[0]
                print(f"First candidate content parts count: {len(candidate.content.parts) if hasattr(candidate.content, 'parts') else 'No parts'}")
                
                # Extract and process the generated image
                for i, part in enumerate(candidate.content.parts):
                    print(f"Processing part {i+1}: type={type(part)}")
                    if hasattr(part, 'inline_data') and part.inline_data is not None:
                        print(f"✓ Found inline image data in part {i+1}")
                        print(f"Image data size: {len(part.inline_data.data)} bytes")
                        print(f"Image mime type: {getattr(part.inline_data, 'mime_type', 'unknown')}")
                        
                        try:
                            image = Image.open(BytesIO(part.inline_data.data))
                            print(f"✓ Image loaded successfully: {image.size[0]}x{image.size[1]} pixels, mode: {image.mode}")
                            
                            # Resize and crop to fit 800x480 display
                            print(f"Resizing and cropping image to {self.COLOR_WIDTH}x{self.COLOR_HEIGHT}...")
                            resized_image = self._resize_and_crop_image(image, self.COLOR_WIDTH, self.COLOR_HEIGHT)
                            print(f"✓ Image resized successfully")
                            
                            # Apply Floyd-Steinberg dithering for e-ink display
                            print(f"Applying Floyd-Steinberg dithering...")
                            dithered_image = self._apply_floyd_steinberg_dithering(resized_image)
                            print(f"✓ Dithering completed successfully")
                            
                            # Save debug copy
                            dithered_image.save('debug_generated_image.png')
                            print(f"✓ Debug image saved as debug_generated_image.png")
                            
                            return dithered_image
                            
                        except Exception as img_error:
                            print(f"✗ Error processing image data: {img_error}")
                            continue
                    else:
                        print(f"Part {i+1} has no inline_data or inline_data is None")
                        if hasattr(part, 'text'):
                            print(f"Part {i+1} contains text: {part.text[:100]}...")
            else:
                print(f"✗ No candidates found in response")
            
            # If no image was generated, raise an error
            print("✗ No image generated from Gemini API")
            raise RuntimeError("Failed to generate image from Gemini API response")
            
        except Exception as e:
            print(f"✗ Gemini image generation error: {e}")
            print(f"Exception type: {type(e)}")
            import traceback
            print(f"Traceback: {traceback.format_exc()}")
            raise
    
    # Matches {random:a|b|c} placeholders. The body may contain spaces, commas
    # and pipes, but no braces, so it never swallows other {variable} fields.
    _RANDOM_PLACEHOLDER_RE = re.compile(r'\{random:([^{}]+)\}', re.IGNORECASE)

    def _resolve_random_placeholders(self, text: str) -> str:
        """Resolve {random:a|b|c} placeholders by picking one option at random.

        This runs before the regular .format() substitution so the generated
        prompt varies from day to day (e.g. the protagonist's clothing colour),
        instead of the LLM defaulting to the first listed option every time.

        Syntax:
          {random:bordeaux red|pink|violet}      -> uniform pick
          {random:bordeaux red*3|pink|violet*1}  -> weighted pick (default 1)

        Each placeholder is resolved independently, so a template may contain
        several of them. Whitespace around options is trimmed and empty options
        are ignored.
        """
        def _pick(match: 're.Match') -> str:
            choices: List[str] = []
            weights: List[float] = []
            for raw_option in match.group(1).split('|'):
                option = raw_option.strip()
                if not option:
                    continue
                weight = 1.0
                weight_match = re.search(r'\*\s*([0-9]+(?:\.[0-9]+)?)\s*$', option)
                if weight_match:
                    weight = float(weight_match.group(1))
                    option = option[:weight_match.start()].strip()
                if not option:
                    continue
                choices.append(option)
                weights.append(weight)

            if not choices:
                # Nothing usable inside the braces - leave the original intact.
                return match.group(0)

            chosen = random.choices(choices, weights=weights, k=1)[0]
            print(f"🎲 Random placeholder resolved: one of {choices} -> '{chosen}'")
            return chosen

        return self._RANDOM_PLACEHOLDER_RE.sub(_pick, text)

    def _create_prompt_generation_request(self, weather_summary: str, events: List[Dict]) -> str:
        """Create the prompt generation request for Gemini"""
        # Get today's date
        today_date = datetime.now().strftime("%Y-%m-%d")
        
        # Format calendar events
        event_texts = []
        if events:
            for event in events[:3]:  # Limit to 3 events
                if event['title']:
                    event_text = event['title']
                    if event['location']:
                        event_text += f" ({event['location']})"
                    # Add time if available
                    if event.get('start'):
                        try:
                            time_str = event['start'].strftime("%I%p").lower()
                            event_text += f" {time_str}"
                        except:
                            pass
                    event_texts.append(event_text)
        
        events_text = "\n".join([f"- {event}" for event in event_texts]) if event_texts else "- No events scheduled"
        
        # Get the configurable prompt template from config
        prompt_template = self.config_service.get('ai_prompt_template')
        if not prompt_template:
            # Fallback to default template if not configured
            prompt_template = self.config_service.default_config['ai_prompt_template']
        
        # Resolve {random:a|b|c} placeholders first so each generation can pick
        # a different option (must happen before .format(), which would choke on
        # the unknown 'random' field otherwise).
        prompt_template = self._resolve_random_placeholders(prompt_template)

        # Replace variables in the template
        prompt_request = prompt_template.format(
            today_date=today_date,
            weather_summary=weather_summary,
            events_text=events_text
        )

        return prompt_request
    
    def _resize_and_crop_image(self, image: Image.Image, target_width: int, target_height: int) -> Image.Image:
        """Resize and crop image to fit target dimensions, cropping from center"""
        # Calculate the aspect ratios
        original_width, original_height = image.size
        target_ratio = target_width / target_height
        original_ratio = original_width / original_height
        
        if original_ratio > target_ratio:
            # Image is wider than target, crop width from center
            new_height = original_height
            new_width = int(original_height * target_ratio)
            left = (original_width - new_width) // 2
            top = 0
            right = left + new_width
            bottom = original_height
        else:
            # Image is taller than target, crop height from center
            new_width = original_width
            new_height = int(original_width / target_ratio)
            left = 0
            top = (original_height - new_height) // 2
            right = original_width
            bottom = top + new_height
        
        # Crop the image from center
        cropped_image = image.crop((left, top, right, bottom))
        
        # Resize to exact target dimensions
        final_image = cropped_image.resize((target_width, target_height), Image.Resampling.LANCZOS)
        
        return final_image
    
    def _apply_floyd_steinberg_dithering(self, image: Image.Image) -> Image.Image:
        """Apply highly optimized vectorized Floyd-Steinberg dithering for e-ink display"""
        import time
        start_time = time.time()
        
        # Define the 6 colors supported by the e-ink display (RGB values)
        eink_colors = np.array([
            [0, 0, 0],       # Black
            [255, 255, 255], # White
            [255, 0, 0],     # Red
            [0, 255, 0],     # Green
            [0, 0, 255],     # Blue
            [255, 255, 0],   # Yellow
        ], dtype=np.float32)
        
        # Pre-compute Floyd-Steinberg weights as constants
        WEIGHT_RIGHT = 7.0 / 16.0      # 0.4375
        WEIGHT_BOTTOM_LEFT = 3.0 / 16.0 # 0.1875  
        WEIGHT_BOTTOM = 5.0 / 16.0      # 0.3125
        WEIGHT_BOTTOM_RIGHT = 1.0 / 16.0 # 0.0625
        
        # Convert image to RGB if not already
        if image.mode != 'RGB':
            image = image.convert('RGB')
        
        # Convert to numpy array for easier manipulation
        img_array = np.array(image, dtype=np.float32)
        height, width = img_array.shape[:2]
        
        print(f"Starting vectorized Floyd-Steinberg dithering on {width}x{height} image...")
        
        # Highly optimized Floyd-Steinberg dithering
        # Process row by row to maintain error propagation order
        for y in range(height):
            # Process entire row pixels for closest color finding (vectorized)
            row_pixels = img_array[y].reshape(-1, 3)  # Shape: (width, 3)
            
            # Vectorized distance calculation for entire row
            # Broadcasting: (width, 1, 3) - (1, 6, 3) -> (width, 6, 3) -> (width, 6)
            pixel_distances = np.sum((row_pixels[:, np.newaxis, :] - eink_colors[np.newaxis, :, :]) ** 2, axis=2)
            closest_indices = np.argmin(pixel_distances, axis=1)
            new_row_pixels = eink_colors[closest_indices]
            
            # Calculate quantization errors for entire row
            row_errors = row_pixels - new_row_pixels
            
            # Process each pixel in the row for error distribution
            for x in range(width):
                # Update current pixel
                img_array[y, x] = new_row_pixels[x]
                
                # Get quantization error for current pixel
                quant_error = row_errors[x]
                
                # Optimized error distribution with pre-computed weights
                # Right pixel (x+1, y)
                if x + 1 < width:
                    img_array[y, x + 1] += quant_error * WEIGHT_RIGHT
                
                # Bottom row pixels (only if next row exists)
                if y + 1 < height:
                    # Bottom-left (x-1, y+1)
                    if x > 0:
                        img_array[y + 1, x - 1] += quant_error * WEIGHT_BOTTOM_LEFT
                    
                    # Bottom (x, y+1)
                    img_array[y + 1, x] += quant_error * WEIGHT_BOTTOM
                    
                    # Bottom-right (x+1, y+1)
                    if x + 1 < width:
                        img_array[y + 1, x + 1] += quant_error * WEIGHT_BOTTOM_RIGHT
        
        # Clamp values to valid range and convert back to PIL Image
        img_array = np.clip(img_array, 0, 255).astype(np.uint8)
        
        end_time = time.time()
        print(f"✓ Vectorized dithering completed in {end_time - start_time:.2f} seconds")
        
        return Image.fromarray(img_array, 'RGB')
    
    def _retry_gemini_api_call(self, func, *args, max_retries=3, initial_delay=1.0, **kwargs):
        """
        Retry Gemini API calls with exponential backoff for timeout exceptions
        
        Args:
            func: The function to call
            *args: Arguments to pass to the function
            max_retries: Maximum number of retry attempts (default: 3)
            initial_delay: Initial delay in seconds (default: 1.0)
            **kwargs: Keyword arguments to pass to the function
            
        Returns:
            The result of the successful function call
            
        Raises:
            The last exception encountered if all retries fail
        """
        last_exception = None
        delay = initial_delay
        
        for attempt in range(max_retries + 1):  # +1 for initial attempt
            try:
                print(f"Gemini API call attempt {attempt + 1}/{max_retries + 1}")
                return func(*args, **kwargs)
                
            except (httpx.ConnectTimeout, httpx.ReadTimeout, httpx.TimeoutException) as e:
                last_exception = e
                if attempt < max_retries:
                    print(f"✗ Gemini API timeout (attempt {attempt + 1}): {type(e).__name__}: {e}")
                    print(f"Retrying in {delay:.1f} seconds...")
                    time.sleep(delay)
                    delay *= 2  # Exponential backoff
                else:
                    print(f"✗ Gemini API timeout after {max_retries + 1} attempts: {type(e).__name__}: {e}")
                    raise e
                    
            except httpx.HTTPError as e:
                last_exception = e
                if attempt < max_retries:
                    print(f"✗ Gemini API HTTP error (attempt {attempt + 1}): {type(e).__name__}: {e}")
                    print(f"Retrying in {delay:.1f} seconds...")
                    time.sleep(delay)
                    delay *= 2  # Exponential backoff
                else:
                    print(f"✗ Gemini API HTTP error after {max_retries + 1} attempts: {type(e).__name__}: {e}")
                    raise e
                    
            except Exception as e:
                # For non-timeout/non-HTTP errors, don't retry
                print(f"✗ Gemini API non-retryable error: {type(e).__name__}: {e}")
                raise e
        
        # This should never be reached, but just in case
        if last_exception:
            raise last_exception

    def cleanup(self):
        """Clean up GPIO resources"""
        try:
            epd_module = _load_epd7in3e()
            if epd_module:
                epd_module.epdconfig.module_exit(cleanup=True)
                self.display_initialized = False
                print("Display GPIO cleanup completed")
        except Exception as e:
            print(f"Error during cleanup: {e}")
