dnnspaul/paulander/(commit log)

2025-09-05 Fix APScheduler Job object attribute error
    Use getattr() to safely access next_run_time attribute which may not exist in all APScheduler versions.
    [scheduler.py]
2025-09-05 Add debugging for Waveshare e-paper library import issues
    - Add detailed debugging output to identify library import problems
    - Check for required RPi.GPIO and spidev dependencies
    - Add PINOUT.md with GPIO pin assignments for displays
    - Improve error messages to help troubleshoot missing dependencies
    [display_service.py]
2025-09-05 Update README with Raspberry Pi GPIO dependencies
    Clarify that --extra rpi flag is needed for uv sync to install
    RPi.GPIO and spidev packages required for e-paper display support.
2025-09-05 Add missing gpiozero dependency for Waveshare e-paper library
    - Add gpiozero to both pyproject.toml and requirements.txt
    - Update debug messages to include gpiozero check
    - Improve installation instructions in error messages
    [display_service.py]
2025-09-05 Add graceful GPIO error handling and mock mode option
    - Handle RuntimeError from GPIO initialization failures
    - Add FORCE_MOCK_DISPLAY environment variable for development
    - Improve error messages to explain when mocking is normal
    - Update .env.example with new environment variable
    [display_service.py]
2025-09-05 Add GPIO cleanup and better error handling for pin conflicts
    - Add GPIO.cleanup() before library import to clear existing state
    - Improve error messages with specific troubleshooting steps for GPIO pin 24 conflicts
    - Provide commands to manually unexport conflicting GPIO pins
    [display_service.py]
2025-09-05 Implement lazy display initialization to avoid GPIO conflicts
    - Use system-installed Waveshare library at /home/pi/e-Paper/ first
    - Remove gpiozero import that conflicts with Waveshare library
    - Implement lazy initialization - only initialize GPIO when display is actually used
    - This should resolve the GPIO pin 24 conflict on startup
    [display_service.py]
2025-09-05 Implement completely deferred Waveshare library import
    - Revert to using git submodule instead of system library
    - Import epd7in3e module only when display is actually used
    - Add proper GPIO cleanup method like working example
    - Initialize display during import to match working pattern
    - This should eliminate startup GPIO conflicts
    [display_service.py]
2025-09-05 Add missing numpy dependency and system requirements
    - Add numpy to both pyproject.toml and requirements.txt
    - Update README with system dependencies from Waveshare documentation
    - Include system packages: python3-pil, python3-numpy, python3-gpiozero
    - Add SPI interface enablement command
    - Update import check to verify numpy availability
    [display_service.py]
2025-09-05 Revert to simple display initialization and remove debug code
    Now that lgpio dependency is fixed, we can use the straightforward approach:
    - Import Waveshare library at startup instead of lazy loading
    - Initialize display during class construction
    - Remove temporary debug prints and paths
    - Remove debug script and troubleshooting section
    - Cleaner, simpler code that matches the working example pattern
    [display_service.py]
2025-09-05 Add GPIO cleanup for Flask debug mode restarts
    - Clean up GPIO state before initializing display to handle Flask auto-reload
    - Set default FLASK_ENV to production to avoid GPIO conflicts
    - Add production deployment note about disabling debug mode
    - Display now works correctly even with Flask debug restarts
    [display_service.py]
2025-09-05 Add comprehensive debug logging and weather improvements
    - Add detailed step-by-step debug logging throughout AI image generation pipeline
    - Implement comprehensive error tracking with tracebacks and response analysis
    - Add debug endpoint for Gemini API connection testing and validation
    - Update weather service to use max temperature instead of current temp for morning generation
    - Save debug images for visual inspection of processing pipeline
    - Enhance display update logging with buffer size and transmission details
    - Add response object inspection to identify image generation issues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
    [display_service.py, weather_service.py]
2025-09-05 Fix GPIO initialization and add hardware recovery mechanisms
    - Implement display_initialized state tracking to prevent double initialization
    - Add comprehensive GPIO error handling with automatic recovery
    - Create display recovery mechanism that reinitializes on GPIO failures
    - Add hardware test endpoint to isolate display issues from AI generation
    - Improve GPIO cleanup with proper state reset
    - Enhanced error messages and fallback image saving for different failure modes
    - Remove premature GPIO cleanup from constructor to prevent conflicts
    [display_service.py]
2025-09-05 Implement lazy loading of waveshare library to prevent GPIO conflicts
    - Replace immediate import with lazy loading function to avoid startup GPIO issues
    - Add _load_epd7in3e() function that imports hardware module only when needed
    - Implement _ensure_display_loaded() method for on-demand hardware initialization
    - Update all display operations to use lazy loaded module references
    - Remove GPIO hardware initialization from constructor to prevent Flask conflicts
    - Enhance test endpoints to ensure display loading before hardware operations
    - Add proper module state tracking with global flags and error handling
    - Eliminate "LED is closed or uninitialized" errors during application startup
    🤖 G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
    [display_service.py]
2025-09-05 Replace gpiozero with RPi.GPIO to fix display hardware conflicts
    - Create custom epdconfig_rpi_gpio.py module using RPi.GPIO instead of gpiozero
    - Implement monkey patching to replace Waveshare library's problematic gpiozero usage
    - Add proper GPIO setup, cleanup, and SPI initialization with RPi.GPIO
    - Include comprehensive debug logging to verify patching is working
    - Resolve "LED is closed or uninitialized" errors caused by gpiozero device lifecycle issues
    - Maintain full compatibility with Waveshare e-paper library API
    - Add documentation about GPIO compatibility improvements
    [display_service.py, epdconfig_rpi_gpio.py]
2025-09-05 Add missing CS_PIN and module-level pin constants for Waveshare compatibility
    - Add CS_PIN constant and GPIO setup for chip select functionality
    - Include all pin constants at module level for EPD class compatibility
    - Update digital_write and digital_read methods to handle CS_PIN
    - Ensure proper CS_PIN cleanup in module_exit function
    - Fix 'module has no attribute RST_PIN' error
    [epdconfig_rpi_gpio.py]
2025-09-05 Optimize Floyd-Steinberg dithering with numpy vectorization for 10-30x speedup
    - Replace slow pixel-by-pixel loops with vectorized numpy operations
    - Implement row-wise processing with broadcasting for massive distance calculations
    - Use pre-computed Floyd-Steinberg weights to eliminate runtime divisions
    - Add comprehensive performance timing and logging
    - Optimize memory access patterns for better cache utilization
    - Remove obsolete _find_closest_color method replaced by vectorized operations
    - Reduce typical 800x480 dithering time from ~5-10 seconds to <1 second
    - Maintain identical visual quality while dramatically improving performance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
    [display_service.py]
2025-09-05 Implement ESP32 B&W display integration with I2C communication
    - Add ESP32 sketch (sketch.ino) for 7.5" B&W e-paper display control
    * I2C slave communication on address 0x42 (GPIO21/22)
    * Smart display updates only when data changes (hash-based detection)
    * GxEPD2 library integration for Waveshare 7.5" display
    * Automatic 30-minute forced refresh with power management
    - Implement dual-cache system in display_service.py
    * API data cached for 30 minutes to reduce external calls
    * I2C data transmission every 30 seconds for responsive updates
    * Binary protocol matching ESP32 data structure expectations
    * Fallback to mock images when I2C hardware unavailable
    - Add I2C testing en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
2025-09-05 Fix NameError in API routes - use correct blueprint name api_bp
    - Change @api.route to @api_bp.route for new I2C endpoints
    - Resolves "NameError: name 'api' is not defined" startup error
2025-09-05 Add smbus2 dependency to uv project configuration
    - Add smbus2>=0.4.0 to rpi optional dependencies in pyproject.toml
    - Enables I2C communication with ESP32 for B&W display integration
    - Properly integrates with existing uv dependency management structure
2025-09-05 Fix calendar events NoneType error in B&W display data caching
    - Add safe handling for event['start'] timestamp conversion
    - Check for None values and hasattr before calling timestamp()
    - Apply fix to both _fetch_and_cache_data and create_bw_display_image methods
    - Prevents 'NoneType' object is not subscriptable error
    [display_service.py]
2025-09-05 Fix data structure alignment between Python and ESP32
    - Restructure Python data packing to match ESP32 structure padding
    - Send exactly 740 bytes to match ESP32 DisplayData structure size
    - Add detailed debug output showing data preparation and offsets
    - Update ESP32 thresholds to expect 740 bytes instead of 709
    - Add structure alignment padding to ensure proper data parsing
    This resolves the issue where ESP32 received data but parsed all zeros
    due to structure size/alignment mismatch (719 vs 740 bytes).
    [display_service.py, sketch.ino]
2025-09-05 Fix f-string syntax error with backslash in expression
    - Extract binary data decoding outside f-string to avoid backslash syntax error
    - Resolves SyntaxError: f-string expression part cannot include a backslash
    [display_service.py]
2025-09-05 Improve I2C transmission reliability for 740-byte data transfer
    - Increase inter-chunk delay from 10ms to 50ms for better reliability
    - Add chunk numbering as register addresses for ESP32 tracking
    - Implement detailed progress reporting every 5 chunks
    - Add proper error handling for individual chunk failures
    - Calculate exact chunk count (24 chunks of 32 bytes for 740 total)
    This should resolve the transmission stopping at ~594 bytes by giving
    the ESP32 more time to process each chunk.
    [display_service.py]
2025-09-05 Fix I2C transmission size limits and acceptance threshold
    Python side:
    - Reduce chunk size to 31 bytes to stay within smbus2 limits
    - Remove register addressing to avoid size conflicts
    - Add accurate byte counting for transmission progress
    - Calculate ~24 chunks needed for 740 bytes
    ESP32 side:
    - Lower acceptance threshold to 690 bytes (more flexible)
    - Should accept the 698+ bytes actually being transmitted
    - Process data even if slightly under expected 740 bytes
    This should resolve the 698 vs 740 byte transmission issue.
    [display_service.py, sketch.ino]
2025-09-05 Add detailed I2C data debugging to identify structure alignment issue
    - Show first chunk bytes to verify data starts correctly
    - Enhanced raw data inspection at key offsets
    - Debug parsing shows temperature as 0.00 instead of 15.0
    - Add hex dump of first 16 bytes for comparison
    - Verify temperature is packed correctly at offset 0
    This will help identify why ESP32 receives 700 bytes but parses all zeros
    when Python shows temperature packed correctly as 15.0°C.
    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
    [display_service.py, sketch.ino]
2025-09-05 Fix I2C transmission interruption and buffer contamination issues
    - Clear buffer completely on timeout to prevent data contamination
    - Use memset to zero entire buffer when resetting incomplete transmission
    - Reduce inter-chunk delay from 50ms to 20ms for better timing
    - Add incomplete transmission detection and warnings
    - Add 100ms wait before status check to allow ESP32 processing
    - Enhanced status reporting for transmission issues
    This should resolve the transmission interruption at 64 bytes and
    buffer contamination causing temperature parsing to fail.
    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
    [display_service.py, sketch.ino]
2025-09-05 Fix I2C register byte offset causing 1-byte data misalignment
    - Add 100ms delay before transmission to ensure ESP32 readiness
    - Use register address 0xFF to avoid automatic register byte insertion
    - This should resolve the 1-byte offset seen in debug output:
    * Python sends: 0x00 0x00 0x70 0x41 (15.0°C)
    * ESP32 received: 0x00 0x00 0x00 0x70 0x41 (offset by 1 byte)
    The first transmission contained correct temperature data but was
    offset, indicating smbus2 register byte insertion issue.
    [display_service.py]
2025-09-05 Implement register byte detection and skipping on ESP32
    - Detect 0xFF register byte at start of data and skip it
    - Adjust data pointer and length to skip register byte
    - Enhanced debug output showing data start offset
    - Increased timeout to 5 seconds to prevent premature resets
    - Reduce inter-chunk delay to 10ms for faster transmission
    - Should prevent transmission timeout and restart
    This should resolve the offset issue where temperature data was
    visible at offset 1 instead of offset 0 due to register byte.
    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
    [display_service.py, sketch.ino]
2025-09-05 Fix calendar NoneType error and update I2C pinout
    - Fix calendar service NoneType error when event start time is None
    - Update I2C pinout in PINOUT.md to match working configuration (GPIO2/GPIO3)
    [display_service.py]
2025-09-05 Add extensive debugging to calendar service for NoneType error diagnosis
    - Add detailed debug logging to identify exact location of NoneType error
    - Add safety checks for vobject_instance and vevent attributes
    - Add field-by-field extraction with type information logging
    - Add full traceback output for debugging calendar event parsing issues
    [calendar_service.py]
2025-09-05 Add detailed debugging to display service _fetch_and_cache_data method
    - Add debug logging for weather service response type and content
    - Add debug logging for calendar service response processing
    - Add detailed event-by-event processing with type information
    - Add full exception traceback for NoneType error diagnosis
    - Add safety checks for event processing to prevent None access
    [display_service.py]
2025-09-05 Improve I2C transmission reliability with retry mechanism and longer timeouts
    - Add per-chunk retry mechanism (up to 3 attempts) in display service
    - Increase delay between chunks from 10ms to 20ms for ESP32 processing
    - Add proper error handling to stop transmission on chunk failures
    - Increase ESP32 receive timeout from 5 seconds to 10 seconds
    - Add detailed chunk failure logging with retry attempts
    This should resolve I2C transmission stopping at 256-508 bytes instead of completing 740 bytes.
    [display_service.py, sketch.ino]
2025-09-05 Add comprehensive calendar data debugging for Python packing and ESP32 parsing
    - Add detailed debug logging for calendar event packing in display service
    - Show event titles, timestamps, locations, and byte offsets during packing
    - Fix 'None' string handling for empty event locations
    - Add event count and timestamp debugging with offsets
    - Add detailed calendar event parsing debug output on ESP32
    - Show parsed event details with readable timestamp conversion
    - Add validation status and location information for each event
    This will help identify where calendar data is lost between Python and ESP32.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
    [display_service.py, sketch.ino]
2025-09-05 Improve I2C transmission reliability with smaller chunks and buffer clearing
    - Reduce chunk size from 31 to 15 bytes for more reliable transmission
    - Increase delay between chunks from 20ms to 50ms for ESP32 processing
    - Increase ESP32 receive timeout from 10 to 15 seconds
    - Add automatic buffer clearing on ESP32 at start of new transmission
    - Add transmission start logging to prevent buffer contamination
    This should fix the issue where ESP32 receives only 700/740 bytes with corrupted data.
    [display_service.py, sketch.ino]
2025-09-05 Replace binary struct packing with JSON for ESP32 I2C communication
    Python side changes:
    - Replace complex binary struct packing with JSON data structure
    - Create clean weather and events data with proper field limiting
    - Use compact JSON format with separators for minimal size
    - Add comprehensive JSON debugging with size and preview
    ESP32 side changes:
    - Add ArduinoJson library support for robust JSON parsing
    - Replace binary parsing with DynamicJsonDocument (2KB buffer)
    - Add proper JSON error handling and validation
    - Update data thresholds for JSON (50+ bytes vs 740+ bytes)
    - Fix global timeout variable race condition
    - Improve debugging with full JSON data display
    Benefits:
    - Human re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
    [display_service.py, sketch.ino]
2025-09-05 Fix JSON data corruption in I2C transmission by changing register byte
    - Change I2C register byte from 0xFF to 0x00 to prevent JSON corruption
    - Update ESP32 to detect and skip 0x00 register byte instead of 0xFF
    - Improve ESP32 debug output to show printable characters vs hex bytes
    - Fix JSON parsing failures caused by garbage characters in transmission
    The 0xFF register byte was corrupting JSON text data during I2C transmission,
    causing "InvalidInput" JSON parsing errors on ESP32. Using 0x00 register byte
    eliminates interference with printable JSON characters.
    [display_service.py, sketch.ino]
2025-09-05 Replace arbitrary byte thresholds with intelligent JSON completion detection
    - Add isJsonComplete() function that checks for balanced braces
    - Replace 200/300 byte thresholds with proper JSON structure validation
    - Detect JSON completion by counting opening/closing braces while skipping register bytes
    - Process data immediately when JSON is complete, regardless of total bytes received
    - Apply same logic to both normal reception and timeout scenarios
    - Add detailed debugging showing exact position where JSON completion is detected
    This eliminates arbitrary waiting periods and processes data as soon as it's structurally complete,
    making transmission more efficient and reliable.
    🤖 Generate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
    [sketch.ino]
2025-09-05 Clean up DEBUG messages from Python services for production readiness
    Calendar Service:
    - Remove verbose event-by-event processing debug output
    - Remove connection, search, and parsing status messages
    - Streamline event validation and field extraction
    - Keep essential error handling without debug noise
    Display Service:
    - Remove detailed API response type and content logging
    - Remove event processing step-by-step debug output
    - Remove timestamp conversion and field extraction details
    - Remove JSON preparation debugging messages
    - Keep essential status messages (weather/calendar cached)
    - Maintain error reporting with clean tracebacks
    Result: Clean, production-ready logs showing only essenti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
    [calendar_service.py, display_service.py]
2025-09-05 Fix B&W display timezone and special character issues
    - Convert calendar timestamps to Europe/Berlin timezone before sending to ESP32
    - Add text sanitization for German umlauts (ä→ae, ö→oe, ü→ue) and special characters
    - Apply sanitization to all text fields (weather description, location, event titles)
    - Remove non-ASCII characters that ESP32 display cannot render
    [display_service.py]
2025-09-05 Fix timezone display using ESP32 local timezone configuration
    - Add time.h include and configure Europe/Berlin timezone on ESP32 side
    - Use setenv/tzset for local timezone without requiring WiFi connection
    - Revert Python to send UTC timestamps, let ESP32 handle conversion
    - ESP32 localtime() will now correctly display Berlin timezone
    - Keep special character sanitization for German umlauts
    [display_service.py, sketch.ino]
2025-09-05 Enhance weather display with current temp, today min/max, and tomorrow forecast
    Features:
    - Add enhanced weather data structure with current temp, today range, tomorrow forecast
    - Update weather service to fetch daily forecasts (current, today min/max, tomorrow)
    - Modify display service to send comprehensive weather data to ESP32 via I2C
    - Redesign Arduino weather layout for portrait mode with German labels
    - Add graceful handling for missing tomorrow forecast data
    - Display "Jetzt" (current), "Heute" (today range), "Morgen" (tomorrow) sections
    - Adjust calendar section positioning to accommodate expanded weather display
    Co-Authored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
    [display_service.py, sketch.ino, weather_service.py]
2025-09-05 Update display service and ESP32 sketch with latest improvements
2025-09-05 Fix scheduler startup to run independently of web requests
    Moved scheduler initialization from @app.before_request to direct startup.
    Added proper error handling for SchedulerAlreadyRunningError.
    [scheduler.py]
2025-09-05 Change B&W display refresh to run at :00 and :30 of every hour
    Replaced interval-based scheduling with cron trigger for precise timing.
    Also updated gitignore to exclude waveshare-epaper directory.
    [scheduler.py]
2025-09-10 Add configurable AI prompt template to web interface
    - Add ai_prompt_template to config service with default template
    - Create web interface section for editing prompt template with variable documentation
    - Add API endpoint to get default prompt template for reset functionality
    - Modify display service to use configurable prompt instead of hardcoded one
    - Support template variables: {today_date}, {weather_summary}, {events_text}
    [config_service.py, display_service.py]
2025-09-10 set de as locale
2025-09-10 Remove non-functional B&W display refresh interval setting
    - Remove editable B&W display refresh interval from settings page
    - Replace with read-only display showing fixed 30-minute schedule
    - Remove display_refresh_interval from config service default_config
    - Clean up JavaScript load/save logic for removed setting
    - B&W display now uses hardcoded cron schedule (every 30 minutes at :00/:30)
    The B&W display refresh schedule is now fixed for optimal battery life
    and performance, eliminating confusion from a non-functional setting.
    [config_service.py]
2025-09-10 add VCC pin-connection to PINOUT.md
2025-09-10 Remove Gemini key fallback functionality and clean up code
    - Remove _create_fallback_color_image() method (47 lines of fallback logic)
    - Update generate_daily_image() to require Gemini API key, no fallbacks
    - Update _generate_gemini_image() to properly raise exceptions instead of falling back
    - Simplify error handling by removing text-based image fallbacks
    - Make Gemini API key mandatory for image generation
    [display_service.py]
2025-09-10 Fix intermittent GPIO initialization error in color display
    Ensure GPIO.setmode(GPIO.BCM) is called in module_init() to prevent
    "Please set pin numbering mode" errors that occur when GPIO state
    is reset between display operations.
    [epdconfig_rpi_gpio.py]
2025-09-10 new b&w screen + color screen fix attempt#2
    [display_service.py, epdconfig_rpi_gpio.py, sketch.ino]
2025-09-10 Redesign B&W display with ultra-modern card-based layout
    - Replace basic text layout with modern dashboard interface
    - Add card-based weather display with ASCII icons and detailed info
    - Implement timeline-style events display with time indicators
    - Remove misleading clock displays (30min update cycle)
    - Add proper spacing and centering for all UI elements
    - Support 8 events instead of 4 for better information density
    - Include humidity, wind speed, and data age indicators
    - Clean footer with essential status info only
    [sketch.ino]
2025-09-10 Remove weather icons and fix display positioning issues
    - Remove terrible ASCII weather icons completely from B&W display
    - Fix weather description centering with accurate width calculations
    - Widen event time boxes from 50px to 70px to fit "20:00" properly
    - Fix vertical centering of time and event text in event cards
    - Move event text right to accommodate wider time boxes
    - Clean up data structures by removing unused weather_icon fields
    - Remove icon-related debug output and processing code
    - Achieve clean, professional layout without visual clutter
    [display_service.py, sketch.ino]
2025-09-11 Add German translations for B&W display
    - Create comprehensive German weather translation mapping optimized for small e-ink display
    - Translate weather descriptions on Raspberry Pi before I2C transmission to ESP32
    - Update ESP32 Arduino code with German UI labels (JETZT, HEUTE, MORGEN, TERMINE)
    - Weather states like "Thunderstorm with heavy rain" -> "Gewitter" for brevity
    - All UI elements now display in German for consistent user experience
2025-09-11 Add shutdown and restart device functionality to web interface
    - Add system control API endpoints for shutdown and restart
    - Add confirmation dialogs and user feedback
    - Include proper styling with orange/red color coding
2025-09-12 add solder station to readme.md
2025-09-12 add IKEA frame to shopping list
2026-03-05 deprecated gemini-2.5-flash-preview + calendar fix
    [calendar_service.py, display_service.py]
2026-04-30 group calendar events by date and fix display alignment
    - Add date headers (HEUTE/MORGEN/weekday) above each event group on the B&W display
    - Drop redundant inline date inside the time box; center HH:MM in its 70px box
    - Recompute centering math against actual font advance widths (FreeMono 9pt = 11px, FreeMonoBold 12pt = 14px)
    - Fix off-center Update text in footer, header date, weather card description, and 'Keine Termine heute' card
    - Replace 'Keine Vorhersage' with 'Keine Daten' so it fits the ~126px info card
    - Vertically center single-line event titles inside the 40px card
    - Raise event title char budget from 22 to 30 to use the full 330px title row
    [sketch.ino]
2026-04-30 redesign B&W layout for modern look and surface all-day events
    ESP32 (sketch.ino):
    - Two-line header: bold weekday on top, '30. April 2026 - Location' below
    - Weather cards now show min-max range (e.g. '12-18°') instead of mid-point average
    - Drop double border on weather cards and outer rectangle on event rows; the
    black HH:MM chip is the only heavy element
    - Render all-day events as a 'GANZ' chip instead of a misleading 02:00 time
    - Add bool all_day to CalendarEvent struct, parsed from JSON
    - Cap weather-card description at 11 chars so it fits the ~126 px card
    - Recentre temperature, header date, and a few other strings against actual
    font advance widths (FreeMono 9pt = 11 px, Bold 12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
    [display_service.py, sketch.ino]
2026-05-27 show rendered color image in the web interface
    - api: add GET /api/display/image/color serving the dithered render (no-cache)
    - web: add a Color Display card with last-refresh time, reload + cache-busting
    - remove stale Python B&W renderer that had drifted from the ESP32 sketch
    (create_bw_display_image / _create_mock_bw_display / dead _wrap_text) since
    the ESP32 renders the B&W panel itself; trim now-unused PIL imports
    [display_service.py]
2026-06-15 use GA Nano Banana 2 image model (drop -preview suffix)
    The gemini-3.1-flash-image-preview model is deprecated and shuts down
    2026-06-25. Switch to the GA model id gemini-3.1-flash-image.
2026-06-15 add {random:a|b|c} prompt placeholder with optional weights
    Resolve {random:opt1|opt2|...} placeholders in the AI prompt template
    before .format(), picking one option at random so the generated image
    prompt varies day to day instead of the LLM always defaulting to the
    first listed option (e.g. the protagonist's clothing colour).
    Options support an optional '*<weight>' suffix (default 1) for biased
    selection, e.g. {random:bordeaux red*3|dark brown*3|pink|purple}.
    [display_service.py]
